lpoulosGS/CM4-SODIMM-Carrier/(commit log)

2026-07-23 updated 2
    [SO-DIMM.kicad_sch, carrier.kicad_pcb, carrier.kicad_sch, cm4-gpio.kicad_sch, cm4-high-speed.kicad_sch, damping-resistors.kicad_sch, level-shifting.kicad_sch]
2026-07-23 Ignore KiCad history files
2026-07-29 Fix broken CM4IO/SODIMM library links and add missing footprints
    Both fp-lib-table and sym-lib-table pointed to other collaborators'
    absolute local paths (a Windows user path and a Linux path), so the
    CM4IO and SODIMM libraries could not resolve on this machine at all.
    Repointed both tables at the project's own libraries/ folder using
    ${KIPRJMOD}-relative paths.
    - Added the missing SODIMM_DDR4_EDGE footprint (260-pin card edge)
    and split the combined CM4 mezzanine footprint into
    Raspberry-Pi-4-Compute-Module-A/-B to match the schematic's
    existing per-connector pin numbering (1-100 / 101-200)
    - Added Connectors.pretty and MCP25625T_E_ML.pretty footprint
    libraries that were referenced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
    [SO-DIMM.kicad_sch, carrier.kicad_pcb, cm4-gpio.kicad_sch, cm4-high-speed.kicad_sch, level-shifting.kicad_sch]
2026-07-30 Remove stale PCB_CARRIER folder
    Leftover carrier.kicad_pro from before the PCB folder rename; superseded
    by PCB/carrier.kicad_pro which has newer KiCad 10 DRC settings.
2026-07-30 Place newly-added footprints on the board
    Position SODIMM_DDR4_EDGE and the split CM4 mezzanine connector
    footprints (Raspberry-Pi-4-Compute-Module-A/-B) at their board
    locations now that the library links resolve correctly.
    [carrier.kicad_pcb]
2026-07-30 Point CM4 mezzanine 3D models at the correct DF40HC part
    The split footprints referenced a nonexistent file for the wrong
    connector variant (DF40C instead of DF40HC). Repointed both to
    KiCad's stock Hirose_DF40HC(3.0)-100DS-0.4V step model.
    Note: offset/rotation were left as previously calibrated for the old
    model rather than guessed at, since this footprint's pads are drawn
    rotated ~90 degrees relative to the stock footprint's native
    orientation. Worth a visual check in KiCad's 3D viewer once the
    kicad-packages3d bundle is installed locally.
2026-07-30 Remove orphaned duplicate CM4 mezzanine connector footprints
    Module1 and Module2 each had a second, stale footprint instance left
    over from before the CM4IO library link was fixed (old 4-hole
    geometry, pads with no resolved net number, stacked exactly on top of
    each other). Removed both, keeping only the correctly-linked pair
    already positioned on the board.
    This leaves ~163 short GND stub tracks dangling that were connected
    to the removed pads. Left in place rather than auto-removed: tracing
    which ones are safe to delete vs. which chain into real routing for
    other nets (SD card, HDMI) needs visual review in the PCB editor, not
    further headless text editing.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
    [carrier.kicad_pcb]
2026-07-30 Remove disconnected duplicate SODIMM_DDR4_EDGE footprint
    J1 had two overlapping footprint instances: one at (100,100) with
    156 real track connections (the live one), and a second at
    (132.575,135.8) with zero net connections that was being repositioned
    in the GUI but was never actually wired up. Removed the disconnected
    duplicate.
    Verified before removing: track/via segment count unchanged
    (3290 in both HEAD and after), confirming no routing was attached to
    the removed instance. DRC's "unconnected items" count dropped from
    ~438 to 45 as a direct result, since the disconnected duplicate's 260
    pads were all contributing false unconnected-pad entries.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
    [carrier.kicad_pcb]
2026-07-30 Fix recurring duplicate SODIMM footprint via re-link by reference
    The one correctly-wired J1 (SODIMM_DDR4_EDGE) footprint had no (path
    ...) link back to its schematic symbol, so every "Update PCB from
    Schematic" concluded J1 had no footprint yet and inserted a fresh
    duplicate. Used KiCad's "Re-link footprints to schematic symbols
    based on their reference designators" option to stamp the missing
    path onto the existing footprint instead.
    Verified: footprint/segment counts unchanged (122 footprints, 3290
    segments, same as HEAD) - only the path field was added, no
    duplicate created.
    This same session accidentally deleted ~54 wires in SO-DIMM.kicad_sch
    (disconnecting ~56 GND/+5V pins on J1), se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
    [carrier.kicad_pcb, cm4-gpio.kicad_sch]
2026-07-30 Sync SODIMM-260_Split library symbol with the schematic's real pin data
    libraries/SODIMM/SODIMM.kicad_sym held a generic/placeholder version
    of this symbol (numeric pin names, smaller body), while the
    schematic's own cached copy had the real, fully pin-mapped CM4 SODIMM
    definition (net names like GND, CSI1_D0_N, etc.) - the source of
    ERC's 7x "doesn't match copy in library 'SODIMM'" warning.
    Replaced the library's copy with the schematic's version (verified
    identical pin 1 across all 7 independently-cached placements before
    picking one as the source). Confirmed via kicad-cli sym upgrade
    (parses cleanly) and ERC (all 7 SODIMM-260_Split mismatches gone,
    136 violations vs 143 before, exactly t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
2026-07-31 Add CAN/PCIe wake signals, drop USB3/CSI-1/most of SPI-1, route GbE pairs
    Schematic changes (confirmed intentional):
    - Renamed dCSI-0_D2/D3_N/P to CSI-0_D2/D3_N/P (same pins, label cleanup)
    - Added CAN_RX/CAN_TX on J1 pins 143/145
    - Added PCIe_WAKE_N on J1 pin 179 / Module1 pin 104 (repurposed from
    SPI-1_MOSI_1V8)
    - Removed USB3-0 and USB3-1 (both ports entirely), the second CSI
    camera interface (dCSI-1, 10 signals), the remaining 4 SPI-1
    signals, and CSI-0/CSI-1_PWDN
    PCB changes:
    - Added carrier.kicad_dru with GbE differential pair rules: intra-pair
    skew <=0.25mm (1000BASE-T MDI tolerance) and inter-pair length
    matched to 49.7-50.7mm, both validated against kicad-cli pcb drc
    - In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
    [SO-DIMM.kicad_sch, carrier.kicad_pcb, cm4-high-speed.kicad_sch]
2026-08-03 Add USB2514B hub and ECS crystal libraries, fix broken footprint/symbol links
    USB2514B's placed symbol referenced a typo'd library nickname
    (USBB2514B_M2) that didn't match the registered USB2514B library, and its
    footprint field had the same mismatch. The ECS-240-18-33Q-DS crystal had no
    symbol library registered at all and was pointing at a generic built-in
    Oscillator footprint instead of its real land pattern. Added the missing
    ECS library files, registered both libraries with ${KIPRJMOD}-relative
    paths, and corrected the lib_id/footprint references in the schematic.
    [carrier.kicad_pcb, carrier.kicad_sch, untitled.kicad_sch]
2026-08-03 Recover crashed sheet hierarchy, add MCP25625 CAN transceiver
    KiCad crashed while USB_HUB and CAN PHY sheets were mid-rename, leaving
    carrier.kicad_sch pointing at USB.kicad_sch and CAN_PHY.kicad_sch, neither
    of which existed on disk. Restored USB_HUB by recovering its content from
    the orphaned untitled.kicad_sch (still had the USB2514B/ECS crystal fixes
    intact), and created a blank CAN_PHY.kicad_sch so the hierarchy loads
    cleanly. The crash also truncated fp-lib-table/sym-lib-table back to an
    earlier state; re-added the missing USB2514B/ECS/MCP25625 entries.
    Also placed the MCP25625 CAN transceiver, moved its library into
    libraries/MCP25625T_E_ML/ to match the convention used by the other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
    [CAN_PHY.kicad_sch, SO-DIMM.kicad_sch, USB.kicad_sch, carrier.kicad_pcb, carrier.kicad_sch, new.kicad_sch]
