lpoulosGS/CM4-SODIMM-Carrier/(notices)

Notices in the files:
PCB/carrier.kicad_pcb:
creativecommons.org/licenses/by/4.0
License: CC BY 4.0
